gztproject/VFD/PCB/VFD.png

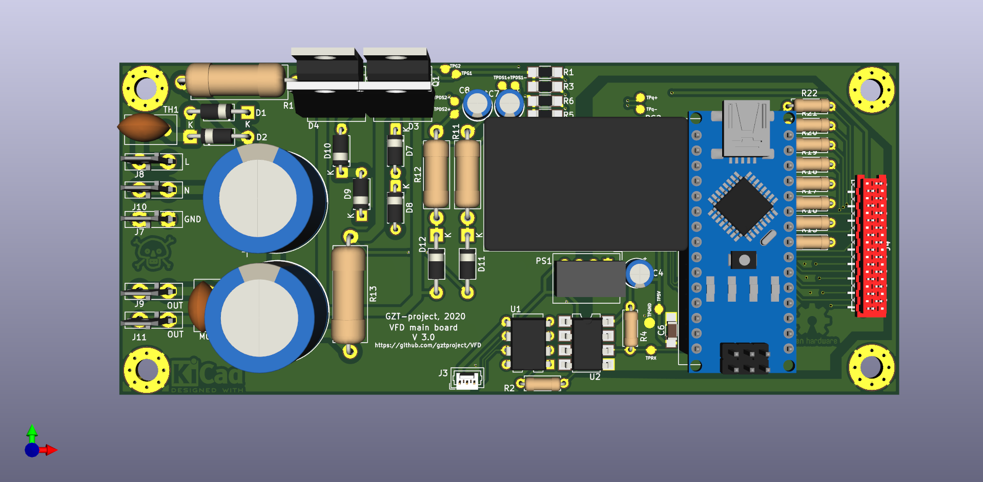
PCB/VFD.png
