gztproject/VFD/PCB/UI.png

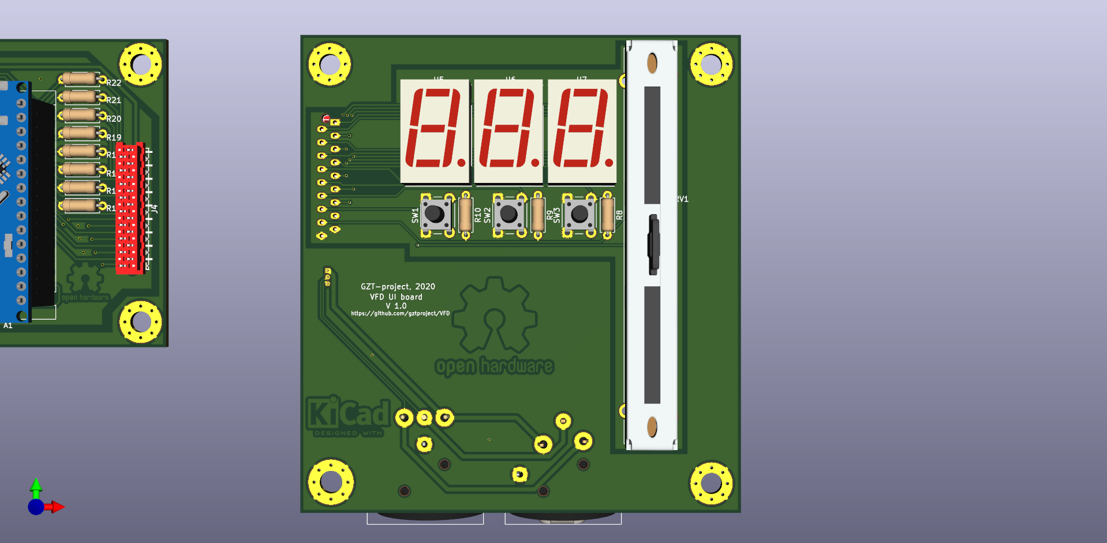
PCB/UI.png
