gztproject/VFD/PCB/VFD.pdf

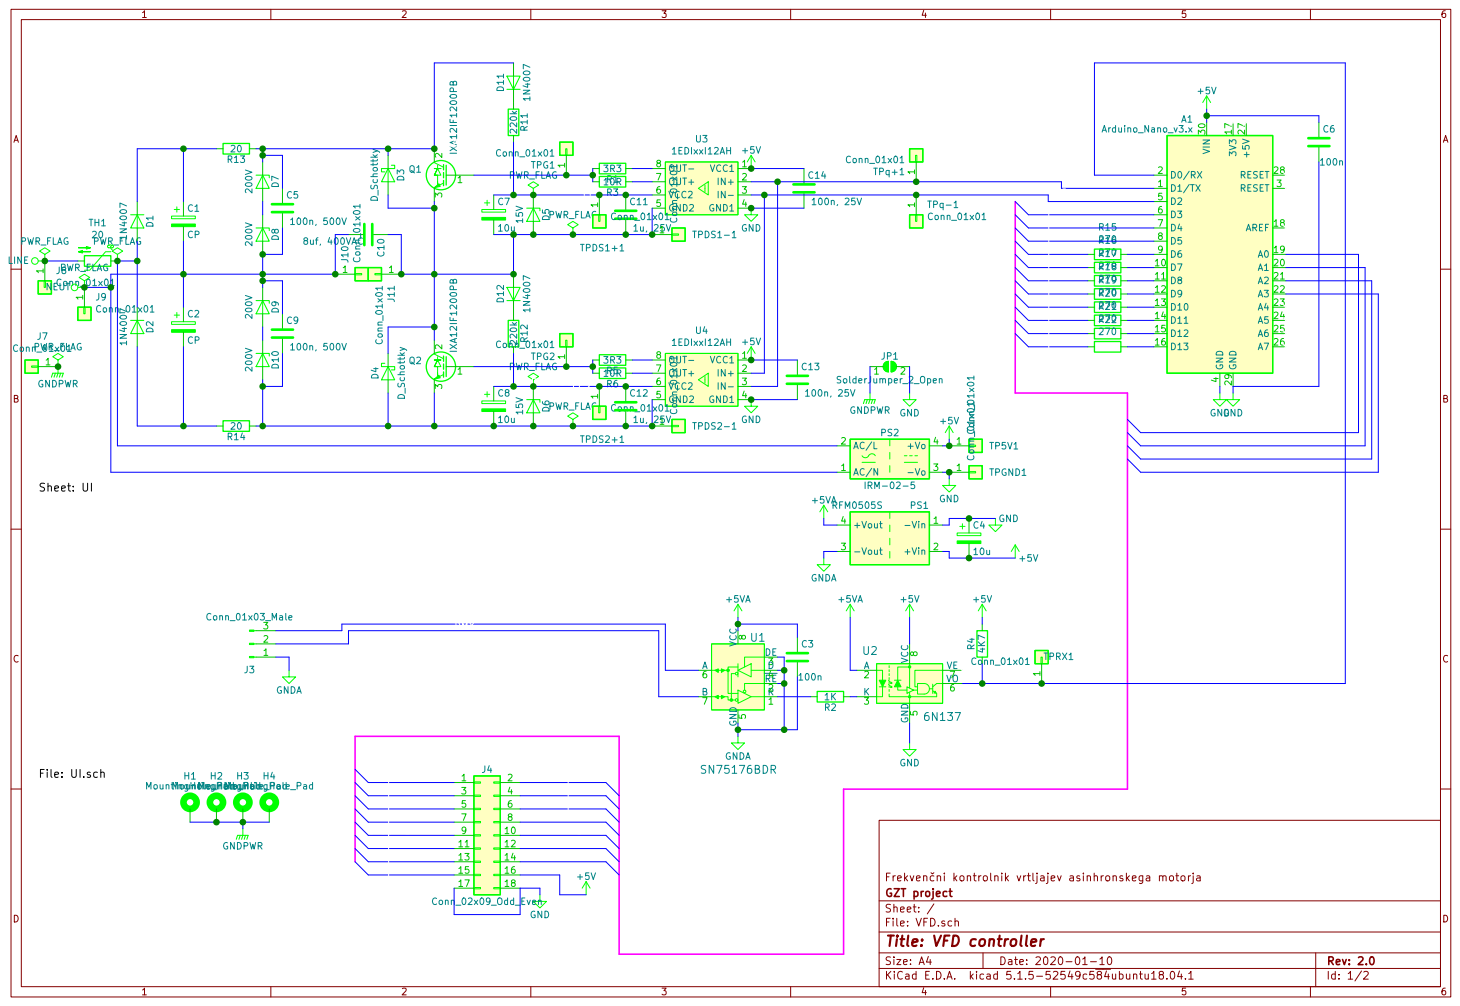
[picture p3: page 1]

Frekvenni kontrolnik vrtljajev asinhronskega motorja
Id: 1/2 Title: VFD controller File: VFD.sch Sheet: / GZT project

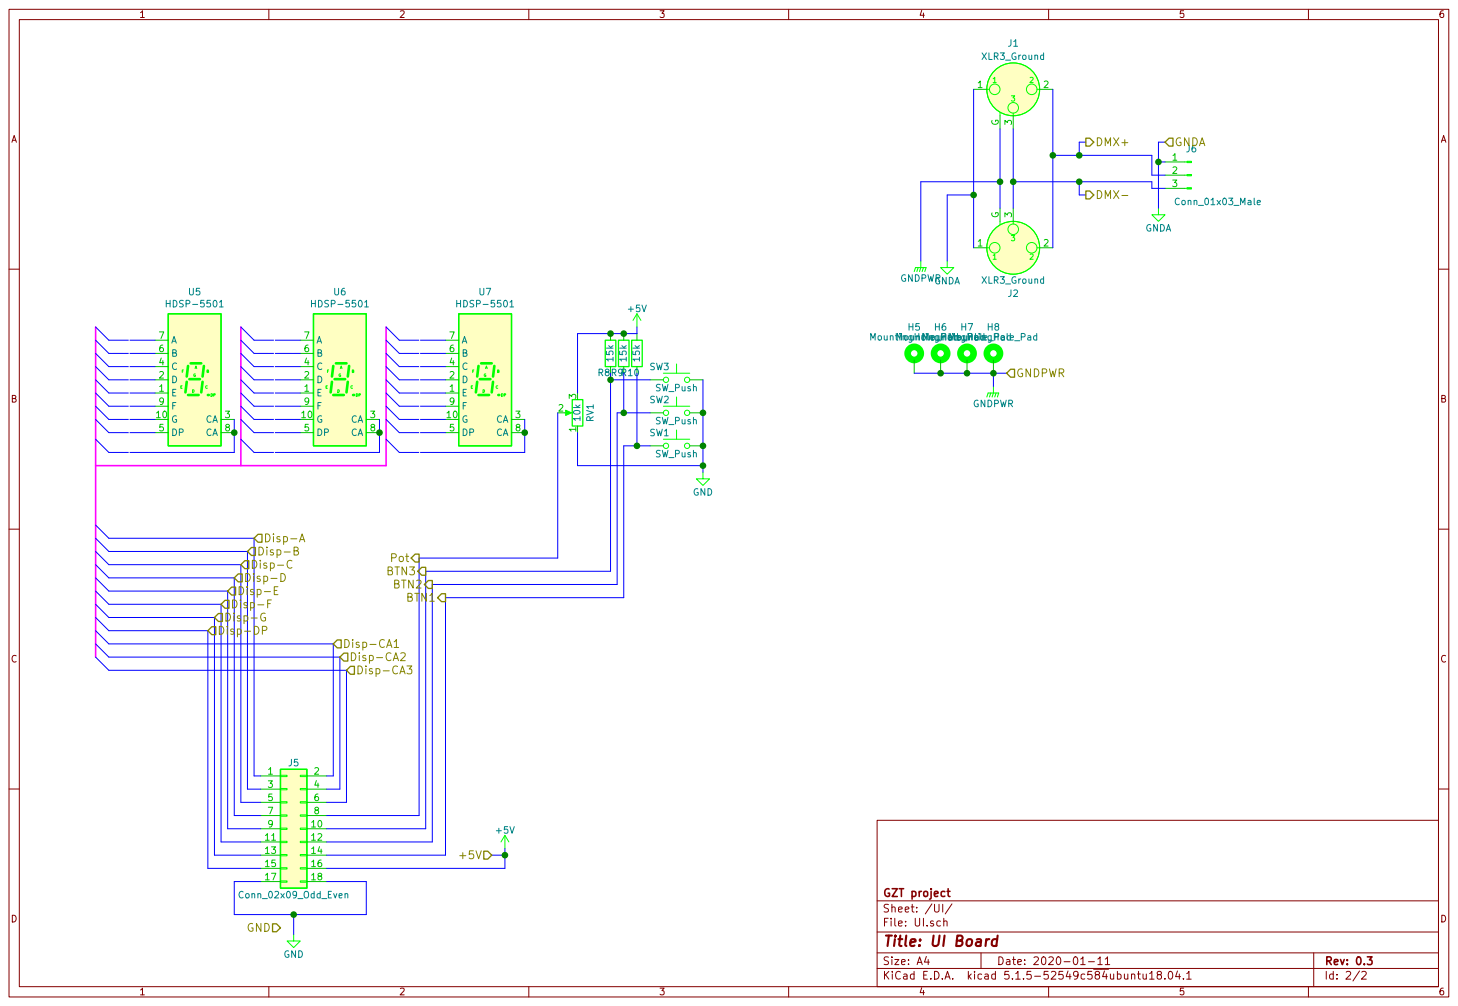
[picture p4: page 2]

GNDA DMX- DMX+ Disp-CA3

File: UI.sch Sheet: /UI/ GZT project

Id: 2/2 Title: UI Board
