gztproject/VFD/PCB/VFD.kicad_pcb

## KiCad design PCB/VFD.kicad_pcb (2020-04-21)

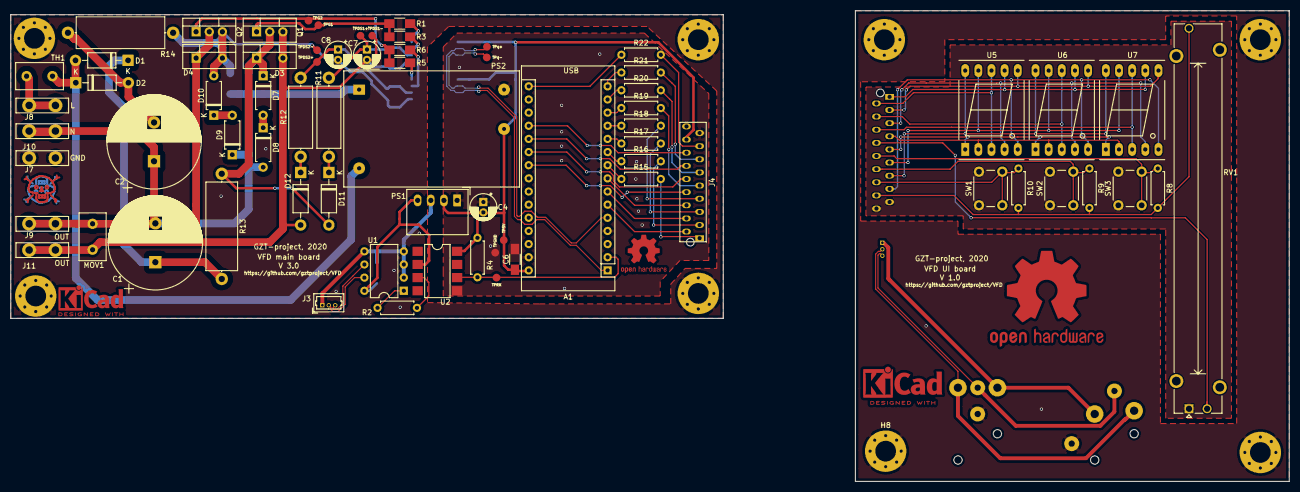
[picture p5: board VFD.kicad_pcb from above]

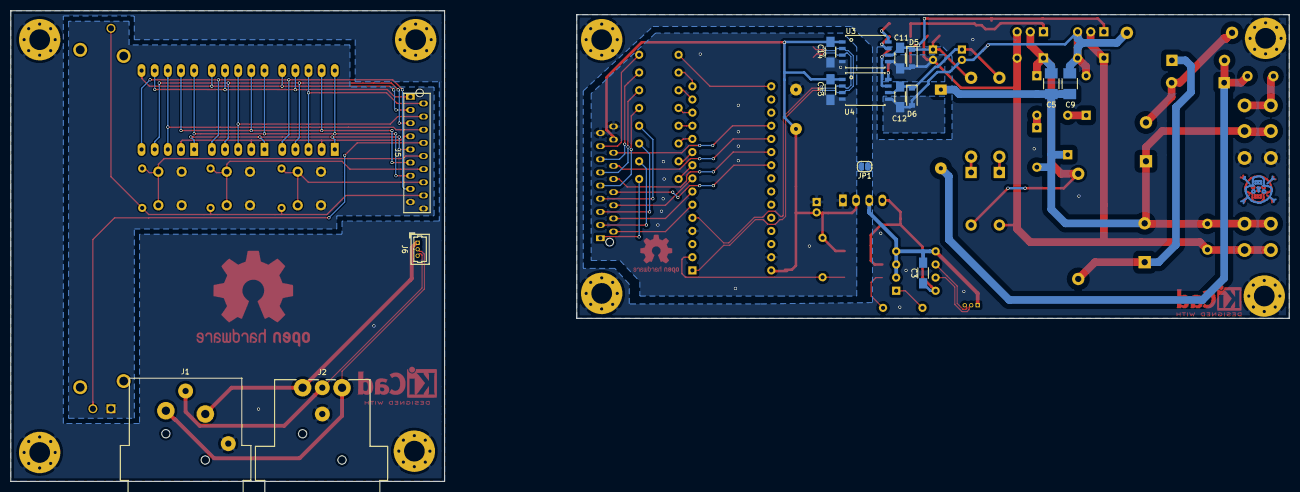
[picture p6: board VFD.kicad_pcb from below]

Board: 2 copper layers, 137.7 x 58.7 mm, 95 parts (16 on the bottom side), 72 nets.

Parts:
A1: Arduino_Nano_v3.x; Arduino_Nano
C1, C2: CP; CP_Radial_D18.0mm_P7.50mm
C3, C6: 100n; C_1206_HandSoldering
C4, C7, C8: 10u; CP_Radial_D5.0mm_P2.00mm
C5, C9: 100n, 500V; C_1210_HandSoldering
C11, C12: 1u, 25V; C_1206_HandSoldering
C13, C14: 100n, 25V; C_1206_HandSoldering
D1, D2, D11, D12: 1N4007; D_DO-41_SOD81_P10.16mm_Horizontal
D3, D4: D_Schottky; TO-220-2_Vertical
D5, D6: 15V; D_SOD-123
D7, D8, D9, D10: 200V; D_A-405_P7.62mm_Horizontal
H1, H2, H3, H4, H5, H6, H7, H8: MountingHole_Pad; MountingHole_4mm_Pad_Via
J1: XLR3_Ground; Jack_XLR_Neutrik_NC3FAAH2_Horizontal
J2: XLR3_Ground; Jack_XLR_Neutrik_NC3MAAH_Horizontal
J3, J6: Conn_01x03_Male; Molex_PicoBlade_53047-0310_03x1.25mm_Straight
J4, J5: Conn_02x09_Odd_Even; CONN-TE-MICROMATCH-9X2-PTH-BOSS
J7, J8, J9, J10, J11: Conn_01x01; FASTON_250_straight_male
JP1: SolderJumper_2_Open; SolderJumper-2_P1.3mm_Open_RoundedPad1.0x1.5mm
MOV1: 650V; C_Disc_D9.0mm_W5.0mm_P5.00mm
PS1: RFM0505S; DCDC-Conv_RECOM_R-78S-0.1
PS2: IRM-02-5; Converter_ACDC_MeanWell_IRM-02-xx_THT
Q1, Q2: IXA12IF1200PB; TO-220-3_Vertical
R1, R5: 3R3; R_1206_HandSoldering
R2: 1K; R_Axial_DIN0207_L6.3mm_D2.5mm_P7.62mm_Horizontal
R3, R6: 10R; R_1206_HandSoldering
R4: 4K7; R_Axial_DIN0207_L6.3mm_D2.5mm_P7.62mm_Horizontal
R8, R9, R10: 15k; R_Axial_DIN0207_L6.3mm_D2.5mm_P7.62mm_Horizontal
R11, R12: 110k; R_Axial_DIN0414_L11.9mm_D4.5mm_P15.24mm_Horizontal
R13, R14: 20; R_Axial_DIN0617_L17.0mm_D6.0mm_P20.32mm_Horizontal
R15, R16, R17, R18, R19, R20, R21, R22: 270; R_Axial_DIN0207_L6.3mm_D2.5mm_P7.62mm_Horizontal
RV1: 10k; Potentiometer_Bourns_PTA6043_Single_Slide
SW1, SW2, SW3: SW_Push; SW_PUSH_6mm_h7.3mm
TH1: 20; C_Disc_D9.0mm_W5.0mm_P5.00mm
TP5V: Conn_01x01; Measurement_Point_Round-SMD-Pad_Small
TPDS1+, TPDS1-, TPDS2+, TPDS2-: Conn_01x01; Measurement_Point_Round-SMD-Pad_Small
TPG1, TPG2: Conn_01x01; Measurement_Point_Round-SMD-Pad_Small
TPGND: Conn_01x01; Measurement_Point_Round-SMD-Pad_Small
TPRX: Conn_01x01; Measurement_Point_Round-SMD-Pad_Small
TPq+: Conn_01x01; Measurement_Point_Round-SMD-Pad_Small
TPq-: Conn_01x01; Measurement_Point_Round-SMD-Pad_Small
U1: SN75176BDR; DIP-8_W7.62mm
U2: 6N137; SMDIP-8_W7.62mm
U3, U4: 1EDIxxI12AH; Infineon_PG-DSO-8-59
U5, U6, U7: HDSP-5501; 7SegmentLED_LTS6760_LTS6780

Connections:
+5V: A1.30, C4.2, C6.1, C13.1, C14.1, J4.16, J5.16, PS1.2, PS2.4, R4.2, R8.2, R9.2, R10.2, RV1.3, TP5V.1, U2.8, U3.1, U4.1
+5VA: C3.1, PS1.4, U1.8, U2.2
/+400V: C1.1, D1.1, R13.2
/+DriverSupply: C7.1, C11.1, D5.1, R11.2, TPDS1+.1, U3.6
/+Gate: Q1.1, R1.2, R3.2, TPG1.1
/+IGBT: C5.1, D3.1, D7.1, D11.2, Q1.2, R13.1
/-400V: C2.2, D2.2, R14.2
/-DriverSupply: C8.1, C12.1, D6.1, R12.2, TPDS2+.1, U4.6
/-Gate: Q2.1, R5.2, R6.2, TPG2.1
/-IGBT: C8.2, C9.2, C12.2, D4.2, D6.2, D10.2, Q2.3, R14.1, TPDS2-.1, U4.5
/BTN1: A1.19, J4.14
/BTN2: A1.20, J4.12
/BTN3: A1.21, J4.10
/DMX+: J3.3, U1.6
/DMX-: J3.2, U1.7
/Disp-A: J4.1, R15.2
/Disp-B: J4.3, R16.2
/Disp-C: J4.5, R17.2
/Disp-CA1: A1.6, J4.2
/Disp-CA2: A1.7, J4.4
/Disp-CA3: A1.8, J4.6
/Disp-D: J4.7, R18.2
/Disp-DP: J4.15, R22.2
/Disp-E: J4.9, R19.2
/Disp-F: J4.11, R20.2
/Disp-G: J4.13, R21.2
/L_NTC: D1.2, D2.1, PS2.2, TH1.1
/MotL: C7.2, C11.2, D3.2, D4.1, D5.2, D12.2, J11.1, MOV1.1, Q1.3, Q2.2, TPDS1-.1, U3.5
/Pot: A1.22, J4.8
/Trig+: A1.1, TPq+.1, U3.2, U4.3
/Trig-: A1.5, TPq-.1, U3.3, U4.2
/UI/BTN1: J5.14, R10.1, SW1.2
/UI/BTN2: J5.12, R9.1, SW2.2
/UI/BTN3: J5.10, R8.1, SW3.2
/UI/DMX+: J1.2, J2.2, J6.2
/UI/DMX-: J1.3, J2.3, J6.3
/UI/Disp-A: J5.1, U5.7, U6.7, U7.7
/UI/Disp-B: J5.3, U5.6, U6.6, U7.6
/UI/Disp-C: J5.5, U5.4, U6.4, U7.4
/UI/Disp-CA1: J5.2, U5.3, U5.8
/UI/Disp-CA2: J5.4, U6.3, U6.8
/UI/Disp-CA3: J5.6, U7.3, U7.8
/UI/Disp-D: J5.7, U5.2, U6.2, U7.2
/UI/Disp-DP: J5.15, U5.5, U6.5, U7.5
/UI/Disp-E: J5.9, U5.1, U6.1, U7.1
/UI/Disp-F: J5.11, U5.9, U6.9, U7.9
/UI/Disp-G: J5.13, U5.10, U6.10, U7.10
/UI/Pot: J5.8, RV1.2
GND: A1.4, A1.29, C4.1, C6.2, C13.2, C14.2, J4.17, J4.18, J5.17, J5.18, JP1.2, PS1.1, PS2.3, RV1.1, SW1.1, SW2.1, SW3.1, TPGND.1, U2.5, U3.4, U4.4
GNDA: C3.2, J1.1, J2.1, J3.1, J6.1, PS1.3, U1.2, U1.3, U1.4, U1.5
GNDPWR: H1.1, H2.1, H3.1, H4.1, H5.1, H6.1, H7.1, H8.1, J1.G, J2.G, J7.1, JP1.1
LINE: J8.1, TH1.2
NEUT: C1.2, C2.1, C5.2, C9.1, D8.2, D9.1, J9.1, J10.1, MOV1.2, PS2.1
unnamed: A1.2, R4.1, TPRX.1, U2.6
unnamed: A1.9, R15.1
unnamed: A1.10, R16.1
unnamed: A1.11, R17.1
unnamed: A1.12, R18.1
unnamed: A1.13, R19.1
unnamed: A1.14, R20.1
unnamed: A1.15, R21.1
unnamed: A1.16, R22.1
unnamed: D7.2, D8.1
unnamed: D9.2, D10.1
unnamed: D11.1, R11.1
unnamed: D12.1, R12.1
unnamed: R1.1, U3.8
unnamed: R2.1, U2.3
unnamed: R2.2, U1.1
unnamed: R3.1, U3.7
unnamed: R5.1, U4.8
unnamed: R6.1, U4.7
