gztproject/VFD/(commit log)

2020-01-16 Trying to find out the right function for PWM
2020-01-17 PWM drive done!
2020-01-17 Added PCB
    [VFD-B_Cu.gbr, VFD-B_Mask.gbr, VFD-B_SilkS.gbr, VFD-Edge_Cuts.gbr, VFD-F_Cu.gbr, VFD-F_Mask.gbr, VFD-F_SilkS.gbr, VFD-NPTH.drl]
2020-02-03 Started work with actual PCB
2020-02-03 Updated PCB, added KiCad files
    [UI-2020-01-11-16-26-03.sch, UI.sch, VFD-2020-01-11-16-26-03.sch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]
2020-02-03 PCB updates
    [UI-2020-01-11-16-26-03.sch, VFD-2020-01-11-16-26-03.sch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]
2020-02-06 PCB V2.0
    [VFD.csv]
2020-02-06 Updated project
    [VFD.sch]
2020-02-13 Added some more inductive surge protection
    [VFD.kicad_pcb, VFD.sch]
2020-02-25 Changed the schema, new IGBTs and drivers
    [VFD.sch]
2020-02-26 Started reworking the PCB layout
    [VFD.kicad_pcb, VFD.sch]
2020-02-27 More work on PCB
    [VFD-B_Cu.gbr, VFD-B_Mask.gbr, VFD-B_SilkS.gbr, VFD-Edge_Cuts.gbr, VFD-F_Cu.gbr, VFD-F_Mask.gbr, VFD-F_SilkS.gbr, VFD-NPTH.drl]
2020-02-27 Added some testPoints
    [VFD-B_Cu.gbr, VFD-B_Mask.gbr, VFD-B_SilkS.gbr, VFD-Edge_Cuts.gbr, VFD-F_Cu.gbr, VFD-F_Mask.gbr, VFD-F_SilkS.gbr, VFD-NPTH.drl]
2020-02-28 More PCB fixes
    [VFD-B_Cu.gbr, VFD-B_Mask.gbr, VFD-B_SilkS.gbr, VFD-Edge_Cuts.gbr, VFD-F_Cu.gbr, VFD-F_Mask.gbr, VFD-F_SilkS.gbr, VFD-NPTH.drl]
2020-04-21 Updated startup pin state, relative include path
2020-04-21 Updated some component values
    [VFD.kicad_pcb, VFD.sch]
